ZONESOUND/ITRI-art-residency/tof_distance_sensor/README.md

# VL53L0X 雙 ToF 距離感測模組

ESP32 + 2x VL53L0X ToF（Time-of-Flight）感測器，用於平面同動車 X/Y 軸手把追蹤。
Serial 輸出 OSC 風格格式，可直接接入 Max/MSP。

---

## 🔥 目前燒錄在 ESP32 的版本

**`tof_c3_supermini_vel_norm/`**（位置 + 速度 mm/s + normalized 速度 -1.0~1.0）

> 這是同動車 TOF 那顆 ESP32 上面**實際在跑的韌體**。
> 拆開來複製副本改的時候，記得燒回這版才會跟 Max 端 `paired_motion/` 的 abstraction 設計相符。

---

## 韌體版本

### 目前使用版本

| 目錄 | 板子 | 濾波 | 輸出格式 | 說明 |
|---|---|---|---|---|
| **`tof_c3_supermini_vel_norm/`** | **ESP32-C3 SuperMini** | **三層濾波 + 速度 EMA + 位置不變 snap-to-0 + post-normalize deadband** | **`/tof fX fY rX rY vX vY vXn vYn`**（8 個值）| **目前燒錄版本**：位置 + mm/s 速度 + normalized -1~1 速度 |

### 前一版（仍可用，差別只是沒做 normalize）

| 目錄 | 板子 | 濾波 | 輸出格式 | 說明 |
|---|---|---|---|---|
| `tof_c3_supermini_vel/` | ESP32-C3 SuperMini | 三層濾波 + 速度 EMA + snap-to-0 | `/tof fX fY rX rY vX vY` | normalize 之前的版本，需要 Max 端自己除 500 |

### 封存版本（`archive/`）

依開發順序：

| 目錄 | 板子 | 濾波 | 輸出格式 | 說明 |
|---|---|---|---|---|
| `archive/tof_noSmooth/` | ESP32 Dev Module | 無 | `x=N,Y=M` | 最早版本，原始距離直出 |
| `archive/tof_optimized/` | ESP32 Dev Module | Median + 自適應 EMA | `/tof fX fY rX rY` | 優化版，雙層濾波 |
| `archive/tof_c3_supermini/` | ESP32-C3 SuperMini | Median + 自適應 EMA + Deadband | `/tof fX fY rX rY` | 三層濾波，僅位置 |

> 各版本前 4 個值（fX fY rX rY）格式都相同，向下相容。
> Max patch 端：4 值版用 `[unpack i i i i]`、6 值版用 `[unpack i i i i f f]`、8 值版（目前）用 `[unpack i i i i f f f f]`。

---

## 硬體接線

### ESP32-C3 SuperMini（目前使用）

```
ESP32-C3 SuperMini    VL53L0X #1 (X軸)    VL53L0X #2 (Y軸)
──────────────────    ────────────────    ────────────────
GPIO 5 (SDA) ──────── SDA ──────────── SDA
GPIO 6 (SCL) ──────── SCL ──────────── SCL
3.3V ─────────────── VIN ──────────── VIN
GND ──────────────── GND ──────────── GND
GPIO 4 ──────────── XSHUT
GPIO 3 ─────────────────────────────── XSHUT
GPIO 0 ──────────── 外接按鈕（另一端接 GND，按下重新校正）
GPIO 8 ──────────── 狀態 LED（校正中閃爍，運行中常滅）
```

### ESP32 Dev Module（舊版）

```
ESP32                 VL53L0X #1 (X軸)    VL53L0X #2 (Y軸)
─────                 ────────────────    ────────────────
GPIO 21 (SDA) ──────── SDA ──────────── SDA
GPIO 22 (SCL) ──────── SCL ──────────── SCL
3.3V ─────────────── VIN ──────────── VIN
GND ──────────────── GND ──────────── GND
GPIO 25 ──────────── XSHUT
GPIO 26 ─────────────────────────────── XSHUT
```

> 兩顆感測器共用 I2C 匯流排，透過 XSHUT 腳位依序啟動並重新分配地址（0x30, 0x31）。
> VL53L0X 只能接 3.3V，不可接 5V。

---

## 安裝與燒錄

### 安裝依賴

在 Arduino IDE 中安裝：

1. **Library Manager** → 搜尋 `Adafruit VL53L0X` → 安裝（會自動安裝 `Adafruit BusIO` 等依賴）

### Board 設定

**ESP32-C3 SuperMini（`tof_c3_supermini`）：**

| 設定項目 | 值 |
|---|-----|
| Board | ESP32C3 Dev Module |
| USB CDC On Boot | **Enabled**（必須，否則 Serial Monitor 無輸出） |
| Partition Scheme | Default 4MB with spiffs |

**ESP32 Dev Module（`archive/tof_optimized` / `archive/tof_noSmooth`，封存版）：**

| 設定項目 | 值 |
|---|-----|
| Board | ESP32 Dev Module |

---

## 運作流程

上電後自動進入三階段狀態機：

```
┌─────────┐     200ms     ┌──────────────┐    ~0.8 秒     ┌─────────┐
│  暖機   │ ────────────→ │    校正      │ ────────────→ │  運行   │
│ WARMUP  │  丟棄不穩讀數  │ CALIBRATING  │  收集中位數    │ RUNNING │
└─────────┘               └──────────────┘               └─────────┘
```

### 校正

**目前燒錄的 `_vel_norm` 版校準 ~1 秒完成**（按一下就好，不用等）：

1. **暖機（200ms）**：丟棄開機後不穩定的讀數
2. **校正（~800ms）**：收集有效樣本（~12 筆），取**中位數**作為零點 offset
   - 校正期間請將手把放在**原點位置**不動
   - 中位數比最小值更抗雜訊；~12 筆已足夠穩
3. **運行**：開始輸出濾波後的距離值

> 舊版 `_vel` 與 `archive/` 仍是 500ms 暖機 + 5 秒校正。只有 `_vel_norm` 縮短成 ~1 秒。

### 重新校正

兩種方式：

1. **按鈕**（`_vel` / `_vel_norm`）：按下外接按鈕（GPIO0）→ 重新校正，Serial 不中斷，Max 不需重連。`_vel_norm` ~1 秒就好。
2. **Serial 指令**：發送字元 `c` → 重新校正

校正期間 GPIO8 LED 閃爍（500ms 間隔），完成後熄滅。
> 注意：GPIO8 是 **ESP32-C3 板載 LED**，ToF 單元裝起來通常看不到（不像 Pressure 有外接 WS2812 燈圈）。實務上「校準完成」的依據是 `/cal_done` + `/tof` 數值在原點歸零。

---

## 三層濾波機制（`tof_c3_supermini`）

```
感測器原始讀值 → 歸零(減 offset) → ① Median → ② 自適應 EMA → ③ Deadband → 輸出
```

### ① Median 濾波（殺突波）

- 窗口大小 = 3，對最近 3 筆取中位數
- 感測器偶爾跳一下（如 120→250→120），中位數會直接忽略 250 這個離群值
- 比 EMA 更適合處理突波，因為 EMA 會被拉走好幾幀

### ② 自適應 EMA（靜止穩、移動快）

- 計算新值與目前 EMA 的差距，自動切換平滑係數：
  - 差距 ≤ 10mm（靜止/緩動）→ alpha = 0.12（新值只佔 12%，非常平滑）
  - 差距 > 10mm（快速移動）→ alpha = 0.6（新值佔 60%，快速跟手）
- 比固定 alpha 好在：靜止時不抖、移動時不拖

### ③ Deadband（鎖住微抖）

- 濾波後的值與上次輸出相差 ≤ 3mm → 不更新，鎖住上次的值
- 確保靜止時輸出完全不動

---

## Serial 輸出格式

Baud rate: **115200**

### 訊息格式（OSC 風格）

| 訊息 | 說明 |
|---|---|
| `/tof <fX> <fY> <rX> <rY>` | 4 值版（archive 舊版），僅位置 |
| `/tof <fX> <fY> <rX> <rY> <vX> <vY>` | 6 值版（`_vel`，前一版），位置 + mm/s 速度 |
| **`/tof <fX> <fY> <rX> <rY> <vX> <vY> <vXn> <vYn>`** | **8 值版（`_vel_norm`，目前燒錄版）**，位置 + mm/s 速度 + normalized -1~1 |
| `/status calibrating` | 進入校正（`_vel_norm`：純開始標記，無倒數數字；`_vel`/archive：後面帶剩餘秒數） |
| `/cal_done <offsetX> <offsetY> <samplesX> <samplesY>` | 校正完成 |
| `/status running` | 開始正常運行 |
| `/status velocity_on` / `velocity_off` | 速度輸出開關切換（`_vel` 起的版本） |
| `/status button_recalibrate` | 按鈕觸發重新校正（`_vel` 起的版本） |
| `/status recalibrating` | 重新進入校正流程（`_vel` 起的版本） |
| `/status filters_reset` | 濾波器已重置 |
| `/error <message>` | 錯誤訊息 |

### `/tof` 數值說明（目前燒錄的 8 值版）

```
/tof <fX> <fY> <rX> <rY> <vX> <vY> <vXn> <vYn>
      ↑         ↑         ↑          ↑
      濾波後     僅歸零     速度        normalized 速度
                          (mm/s)      (-1.0 ~ +1.0)
```

| | filtered (fX, fY) | raw (rX, rY) | velocity (vX, vY) | normalized vel (vXn, vYn) |
|---|---|---|---|---|
| 型態 | int (mm) | int (mm) | float (mm/s) | float (-1.0 ~ +1.0) |
| 歸零（offset） | 有 | 有 | — | — |
| 三層濾波 | 有 | 無 | — | — |
| 速度 EMA 平滑 | — | — | 有 | 同 vX/vY |
| Post-normalize deadband | — | — | — | 有（< 0.02 視為 0） |
| Post-normalize EMA | — | — | — | 預留，預設關閉 |
| 用途 | **位置控制** | **除錯** | **絕對速度** | **直接接聲音映射** |

#### 速度 (vX, vY, vXn, vYn) 特性

**vX, vY (mm/s)**：

- 單位：mm/s，帶正負方向
  - 正值 = 遠離感測器（向中線移動）
  - 負值 = 靠近感測器（向邊緣移動）
- 從 fX/fY（deadband 後穩定值）計算
- **位置沒變就直接 = 0**，速度沒有慣性尾巴（不會在停下後緩慢衰減）
- 移動中才套 EMA 平滑（VEL_SMOOTH = 0.06）→ 加速時連續 ramp，不跳動
- 典型範圍：慢 ±50, 中 ±200, 快 ±500~1000

**vXn, vYn (-1.0 ~ +1.0)**：

- normalized 浮點，靜止時 = 0.0（exact）
- 公式：`clip(vX / VEL_MAX, -1.0, 1.0)` 後做 deadband
- VEL_MAX 預設 500，演出當下覺得太敏感（飽和太快）→ 在韌體 .ino 改大、覺得太鈍 → 改小（要重燒）
- abs 落在 < 0.02 直接歸 0（壓掉浮點微抖跟極微小速度）
- 預留 `VEL_NORM_SMOOTH` 參數（預設 0 關閉），要追加平滑改一行常數即可
- Max 端 `[unpack i i i i f f f f]` 接到後直接接 abstraction 的 outlet，不需再 normalize

### Serial 指令

| 指令 | 功能 | 版本 |
|---|---|---|
| `c` | 重新校正（暖機 + 收集；`_vel_norm` ~1 秒、其餘 ~5.5 秒） | 全版本 |
| `r` | 重啟濾波器（清除歷史，保留 offset） | 全版本 |
| `v` | 切換速度輸出開/關（預設開） | `_vel` 版 |

---

## Max/MSP 接線

### 基本接收鏈

```
[serial /dev/cu.usbmodem-XXXX 115200]    ← ESP32-C3 用 usbmodem，ESP32 用 usbserial
        |
    [sel 10]          ← 以換行符號 (ASCII 10) 分割訊息
        |
   [zl group]         ← 收集一行的 bytes
        |
     [itoa]           ← bytes → 字元
        |
   [fromsymbol]       ← 字串 → Max symbol list
        |
  [route /tof /status /cal_done /error]
     |      |         |          |
[unpack i i i i]    ...        ...
  |   |   |   |
 fX  fY  rX  rY
```

### 分離 filtered、raw、velocity、normalized velocity

**目前燒錄版本（`_vel_norm`，8 值）**：

```
[route /tof]
     |
[unpack i i i i f f f f]
 |  |   |  |  |   |  |   |
 fX fY rX rY vX vY vXn vYn
```

各版本對應：

| 韌體版本 | unpack 物件 |
|---|---|
| `archive/tof_c3_supermini`（4 值） | `[unpack i i i i]` |
| `tof_c3_supermini_vel`（6 值） | `[unpack i i i i f f]` |
| **`tof_c3_supermini_vel_norm`（8 值，目前燒錄）** | **`[unpack i i i i f f f f]`** |

### 映射到 GL 座標

現有的 `tof_sensors.maxpat` 將 filtered 值映射為 -1.0 ~ 1.0：

```
filtered_x → [/ 360.] → [* 2.] → [- 1.] → x_gl (-1.0 ~ 1.0)
filtered_y → [/ 320.] → [* 2.] → [- 1.] → y_gl (-1.0 ~ 1.0)
```

### Max/MSP Patch 檔案

| Patch | 說明 |
|---|---|
| `tof_sensors.maxpat` | Serial 接收 + 數值顯示 + GL 座標映射 + pictslider 視覺化 |
| `tof_line_draw.maxpat` | 接收 GL 座標，用 `jit.gl.mesh` 畫連續線條，有拖尾消失效果 |

---

## 參數調整

在 `.ino` 檔案頂部可調整以下參數：

### 感測器參數

| 參數 | 預設值 | 說明 |
|---|---|---|
| `TIMING_BUDGET_US` | 33000 (33ms) | 感測器量測時間，越大越精確但越慢 |
| `OUTPUT_INTERVAL_MS` | 20 (50Hz) | 輸出間隔，不要低於 timing budget 的兩倍 |
| `WARMUP_MS` | 200（`_vel_norm`）/ 500（`_vel`·archive） | 暖機時間 |
| `CALIB_MS` | 800（`_vel_norm`）/ 5000（`_vel`·archive） | 校正收集時間。`_vel_norm` 縮短成 ~1 秒「按一下即校準」 |
| `RANGE_MAX` | 2000 | 有效量測範圍上限 (mm) |

### 濾波參數（位置）

| 參數 | 預設值 | 說明 |
|---|---|---|
| `MEDIAN_WINDOW` | 3 | Median 窗口，越大越抗突波但延遲越高 |
| `ALPHA_SLOW` | 0.12 | 靜止時 EMA 係數，越小越平滑 |
| `ALPHA_FAST` | 0.6 | 移動時 EMA 係數，越大越跟手 |
| `ADAPTIVE_THRESH` | 10.0 | 靜止/移動切換閾值 (mm) |
| `DEAD_BAND_MM` | 3 | Deadband 門檻，低於此變化量不更新 |

### 速度參數（`_vel` 與 `_vel_norm`）

| 參數 | 預設值 | 說明 |
|---|---|---|
| `VEL_SMOOTH` | 0.06 | 速度 EMA 平滑係數，越小 ramp 越緩（連續漸變），越大越即時 |

### Normalize 參數（`_vel_norm` 版專屬）

| 參數 | 預設值 | 說明 |
|---|---|---|
| `VEL_MAX` | 500.0 | normalize 的分母（mm/s）。typical 快動作上限。改大 → normalized 比較不會飽和；改小 → 動一下就達 ±1.0 |
| `VEL_NORM_DEADBAND` | 0.02 | normalize 後 abs 小於此值直接歸 0。壓掉浮點微抖、極微小速度殘留 |
| `VEL_NORM_SMOOTH` | 0.0 | post-normalize EMA。0 = 關閉。> 0 啟用（例如 0.2）會對 normalized 再平滑一層，會犧牲反應力

**VEL_SMOOTH 效果對照**（@ 50Hz）：

| VEL_SMOOTH | 63% 反應時間 | 適合場景 |
|---|---|---|
| `0.03` | ~0.67 秒 | 非常緩慢的漸變，適合環境音控制 |
| `0.06` | ~0.33 秒 | 預設值，平滑漸變 |
| `0.10` | ~0.20 秒 | 較快反應，適合節奏控制 |
| `0.20` | ~0.10 秒 | 即時反應，有少量平滑 |
| `0.35` | ~0.06 秒 | 幾乎即時，但可能有輕微跳動 |

> 反應時間公式：`-DT / ln(1 - VEL_SMOOTH)` 秒

### 調整建議

| 你覺得... | 調什麼 |
|---|---|
| 靜止時還在抖 | `DEAD_BAND_MM` 加大到 4~5 |
| 手動了但反應太慢 | `ALPHA_FAST` 加大到 0.7~0.8 |
| 移動中數值不夠滑順 | `ALPHA_FAST` 降到 0.4~0.5 |
| 偶爾還有突波穿透 | `MEDIAN_WINDOW` 改成 5 |
| 靜止↔移動切換太敏感 | `ADAPTIVE_THRESH` 加大到 15~20 |
| 感測器讀值本身不穩 | `TIMING_BUDGET_US` 加大到 50000 |
| 速度變化太跳 | `VEL_SMOOTH` 降到 0.03 |
| 速度反應太慢 | `VEL_SMOOTH` 加大到 0.10~0.20 |
| 停下後速度沒歸零 | 檢查 `DEAD_BAND_MM`，要讓 fX/fY 真的鎖住才會觸發歸零分支 |
| Normalized 速度動一下就飽和（總是 ±1） | `VEL_MAX` 加大（例：500 → 800） |
| Normalized 速度太鈍（怎麼動都偏小） | `VEL_MAX` 減小（例：500 → 300） |
| 靜止時 normalized 偶爾跳出小數 | `VEL_NORM_DEADBAND` 加大（0.02 → 0.05） |
| Normalized 0→1 爬升太陡，想再柔一點 | `VEL_NORM_SMOOTH` 改成 0.15~0.3 |

---

## 疑難排解

| 問題 | 可能原因 | 解法 |
|---|---|---|
| Serial Monitor 無輸出 | ESP32-C3 未啟用 USB CDC | Tools → USB CDC On Boot → **Enabled**，重新燒錄 |
| `/error sensor1_init_failed` | 感測器接線鬆脫或 I2C 腳位錯誤 | 檢查 SDA/SCL/XSHUT 接線與供電 |
| 數值不動（一直是 0） | 校正時手把不在原點 | Serial 送 `c` 或按外接按鈕重新校正 |
| Max 收不到資料 | Serial port 被 Arduino Serial Monitor 佔用 | 關閉 Serial Monitor 再開 Max |
| Max 收到亂碼 | Baud rate 不對 | 確認 Max 的 serial object 設為 115200 |
| 編譯失敗 `{build.partitions}` | Board 沒選對 | 選 ESP32C3 Dev Module，設好 Partition Scheme |
