ZONESOUND/ITRI-art-residency/live_demo/README.md

# live_demo — Ableton Live Demo 專案

「同動車 Live Demo」的 Ableton Live 現場 demo 專案。與 `paired_motion/`（Max/MSP 演出主程式）是**兩套獨立的東西**，各自開、各自存。

## 檔案位置

```
live_demo/
└── Live_Demo Project/
    ├── ITRI_show_MIDI.als     ← 演出 set 最新版：10/9 排練後調整 MIDI 對應與參數，10/12 第四幕配樂換成 20261007_小星星.aif
    ├── ITRI_show.als          ← 演出 set，10/7 排練調整後的版本
    ├── Live_Demo.als          ← 早期 demo set
    ├── Live_Demo_macstudio.als← demo set 的 Mac Studio 版
    ├── SceneBridge.amxd       ← M4L：從 UDP 7400 收整數 N，觸發 Live 第 N 個 scene（給外部 Max patch 切段落）
    ├── autoStart.amxd         ← M4L：載入後讓 Live 開始播放
    ├── recording_bell.wav、recording_bell_C.wav、recording_melody.wav、Night animals.wav ← 配樂素材（走 Git LFS）
    ├── Ableton Project Info/  ← Ableton 專案 metadata（須含 Project*.cfg，見下）
    ├── Samples/Imported/      ← Collect All and Save 收進來的音檔（走 Git LFS）
    ├── Presets/               ← 專案內的 device presets
    └── Backup/                ← Ableton 自動備份（已被 .gitignore 忽略，不進 repo）
```

## 怎麼開始工作

- **直接開 repo 裡的 set**（演出用 `ITRI_show_MIDI.als`），不要在別的地方另存分身，否則會兩邊改、對不起來。排練現場來不及 push 而另存的，回來後放回這個資料夾再 commit。
- Mac mini 桌面上有一個原生 Finder 捷徑 `Live_Demo.als`（左下角有箭頭圖示），雙擊即可用 Ableton 開啟本尊。
  - 這是 macOS 原生 alias，不是 Unix symlink——後者會每次跳「Verifying…」而且可能開不起來。
  - 換到別台電腦時，這個桌面捷徑不會跟著 git 走，需要各自在該電腦重建（見下）。

## Git / 版本備份

一般流程（在 repo 根目錄）：

```
git add -A
git commit -m "說明這次改了什麼"
git push
```

- **音檔走 Git LFS**：`.gitattributes` 已設定，`live_demo/` 底下的音檔（wav/aif/aiff/mp3/flac/m4a）會自動走 Git LFS，不會撐爆 git 歷史。未來在 Ableton 按 **Collect All and Save** 收進 `Samples/` 的音檔都會自動走 LFS。
- **`Backup/` 不進 repo**：Ableton 自動備份由 `.gitignore` 排除（git 本身就在做版本控制）。
- **`Ableton Project Info/` 必須含 `Project*.cfg`**：這顆 cfg 是 Ableton 判定「這個資料夾是一個 Project」的依據。一般的 Cmd+S **不會**產生它，只有 File → **Collect All and Save**（或 File → Manage Files → Manage Project）才會寫入。cfg 不存在時該資料夾會是空的，而 **git 無法追蹤空資料夾**，clone / pull 到另一台就不會被認成專案。commit 前先確認 Finder 裡看得到這顆 cfg。
- **commit 前確認 LFS 生效**：`git lfs ls-files` 應列出 `Samples/` 底下的音檔。若在沒裝 git-lfs 的環境 commit，音檔會以原始檔進歷史（撐大 repo），需 reset 重來。

## 換到其他電腦時（例如非 Mac mini）

1. `git clone` 本 repo。
2. **裝 Git LFS**（否則音檔只會拿到指標檔）：
   ```
   brew install git-lfs
   git lfs install
   git lfs pull        # 把音檔實體抓下來
   ```
3. 用 Ableton 開 `live_demo/Live_Demo Project/Live_Demo.als`。
4. （選用）在該電腦桌面自建捷徑：Finder 裡對 `Live_Demo.als` 按右鍵 →「製作替身 / Make Alias」→ 拖到桌面。

## GitHub LFS 額度

免費 1GB 儲存 + 1GB/月流量，一般 demo 足夠；音檔大量成長時再評估付費或改策略。
