ZONESOUND/ITRI-art-residency/(commit log)

2026-05-05 fix(tof_vel): snap velocity to 0 when position unchanged
    EMA smoothing was applied unconditionally, so velocity decayed slowly
    (~2s tail) instead of going to 0 the moment movement stopped. Velocity
    should be a derivative of position — no movement, no velocity, no
    phantom inertia. Now we only smooth while fX/fY is actually changing.
    Also corrects README which previously claimed velocity was 0 when
    stationary; that was the intent but not the behavior.
    [tof_c3_supermini_vel.ino]
2026-05-05 tweak(breath_c3): exponential dot speed + dynamic tail length
    LED dot rotation now uses speed ∝ out² / 10 (signed) so light blowing
    spins slowly and strong blowing accelerates dramatically. Tail length
    scales with airflow strength (2~8 LEDs) instead of fixed 3, with a
    longer decay curve. README updated to match.
    [breath_0115_c3.ino]
2026-05-05 add piezo_detect_who firmware + label pressure_2hands_light outlets
    - piezo_detect_who: single-channel 8kHz piezo streamer with WHO
    identification protocol (responds "ID:piezo"), based on piezo_detect.ino.
    Separate from piezo_4drum — for FluCoMa / MuBu / SC feature extraction.
    - pressure_2hands_light: add comment labeling the unpack outlets
    (hand1_f, hand2_f, hand1_raw, hand2_raw).
2026-05-05 docs(pressure): add pressure_sensor README
    Documents the dual-FSR + dual-LED-ring pressure module for the
    同動車 (Synchronous Movement Vehicle): hardware, three-state
    calibration/idle flow, /pressure output format, WHO protocol,
    tunables, troubleshooting. Includes design context from the Yi-Shan
    day-care workshop observations (per Paul's 2026-03-27 notes) — why
    hands are kept independent and why IDLE_TIMEOUT can't be short.
2026-05-05 docs(readme): restructure top-level README around 同動車 trio
    - Group pressure / tof / piezo as the 同動車 trio with WHO IDs;
    list breath, duo_pulse, piezo_detect_who, piezo_detect_fft, and
    vision modules as standalone.
    - Add a WHO Identification Protocol section explaining how to
    distinguish the three sensors on a shared USB Hub, including
    the known DEVICE_ID collision between piezo_4drum and
    piezo_detect_who.
    - Replace generic one-liners with concrete per-module descriptions
    (filter chain, output format, latest firmware folder, etc.) and
    link to each subdirectory README.
    - Project framing now references 節奏繞纏 / Rhythmic Entanglements
    and the 同動車 (Synchron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
2026-05-05 chore: archive old firmware/patches under each sensor's archive/
    Mark the current production versions and move all earlier firmware /
    Max patches into archive/ subdirs:
    - tof_distance_sensor/archive/: tof_c3_supermini, tof_optimized, tof_noSmooth
    - pressure_sensor/archive/: pressure_2hands.maxpat (older Max patch)
    - piezo_detect/archive/: piezo_paul, piezo_detect.ino, piezo_demo1.maxpat,
    led_test (small LED test utility)
    Current code stays at top level: tof_c3_supermini_vel/, pressure_2hands/,
    piezo_4drum/. Latest Max patches stay at top level: tof_sensors.maxpat,
    tof_line_draw.maxpat, visualization/tof_visual.maxpat,
    pressure_2hands_light.maxpat, piezo_demo2.maxpat. Update tof and
    press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
2026-05-05 docs(piezo_4drum): document /piezo/stream + sync pin map and params
    Update README to match the current piezo_4drum.ino:
    - Pin map matches the latest GPIO mapping (piezo: 4/3/0/1, LED: 6/5/10/7)
    - Document the /piezo/stream continuous output (50Hz, post-baseline)
    alongside the discrete /piezo hit events, and explain the design
    split (hit → discrete sound, stream → continuous control)
    - Parameter table updated to actual defaults (THRESHOLD_DELTA=250,
    HITS_REQUIRED=4) and adds BASELINE_ALPHA_SHIFT, FILTER_SHIFT,
    LED_MIN_MS, LED_MAX_MS, LED_ACTIVITY_THRESHOLD, STREAM_INTERVAL_MS
    - Reference piezo_demo2.maxpat as the implementation example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
2026-05-05 feat(tooling): add serial_auto_detect for WHO-based USB port discovery
    Node.js script for Max [node.script] that auto-discovers which USB port
    each 同動車 sensor is on by sending "WHO\n" and matching the
    "ID:tof|pressure|piezo" responses. Solves the USB Hub port-order
    ambiguity so users don't have to manually identify ports each time.
    Outputs port names (without /dev/tty. prefix) on outlets named after
    each device ID, plus "missing"/"done"/"error" status outlets.
    Auto-runs on load and re-runs on "scan" or bang.
    node_modules already covered by .gitignore.
    [auto_detect.js]
2026-05-05 tweak(piezo_demo2): add manual bang button to gate the trigger chain
    Insert a bang (obj-84) between obj-1 and the downstream obj-32/obj-34
    so the chain can be re-fired manually. Also picks up the latest
    usbmodem port names from this session.
2026-05-06 docs(serial_auto_detect): add module README + diagnostic CLI + Max test patch
    serial_auto_detect/
    - README.md: usage guide, code logic walkthrough, six caveats from
    this debugging session (ESP32-C3 USB CDC boot reset timing,
    Node-for-Max init delay, Max [serial] needs metro driver, [serial]
    port-letter auto-grab race condition, Resource busy after auto-open,
    firmware WHO support requirement)
    - who_probe.js: standalone CLI tool for single-port WHO probe with
    timestamped raw byte logging, bypasses Max for diagnostics
    - auto_detect.js: longer boot wait (1200ms) + retry every 400ms +
    buffer dump on failure for clearer error output
    - auto_detect_test.maxpat: minimal patch demonstratin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
    [auto_detect.js, who_probe.js]
2026-05-06 docs(piezo_detect): add top-level README
    Folder previously had only piezo_4drum/README.md (firmware-level docs).
    Adds an overview README at the piezo_detect/ top level describing:
    - The "one interface, two interaction modes" design (hit events vs
    continuous stream for tap vs scratch/touch)
    - Current vs archived firmware versions
    - Serial output formats (both /piezo and /piezo/stream)
    - Cross-links to piezo_4drum/, archive/, and serial_auto_detect/
    Matches the README pattern already used by pressure_sensor/ and
    tof_distance_sensor/.
2026-05-06 feat(paired_motion): scaffold integration project for art residency demo
    Sets up paired_motion/ as the performance-grade integration folder for the
    ITRI art residency demo (同動車 / Synchronous Movement Vehicle integrating
    the Pressure / TOF / Piezo trio). Companion to serial_auto_detect/ but
    distinct in lifecycle: serial_auto_detect/ stays the lab/debug environment,
    paired_motion/ is frozen at known-good state for performance.
    Skeleton only — sensor abstractions, sound design, and main patch logic
    to be authored manually. Folder layout:
    paired_motion/
    ├── paired_motion.maxproj Max Project root, auto search-path
    ├── main.maxpat Skeleton with [node.scr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
2026-05-06 feat(tof): add tof_c3_supermini_vel_norm — firmware-side velocity normalization
    User decision: do velocity -1.0~+1.0 normalization on the firmware side
    rather than in Max abstractions. Cleaner downstream patches, all sensors
    share the same "single layer" output convention.
    New firmware (copied from tof_c3_supermini_vel/, NOT in-place modified):
    - Output now 8 floats: /tof fX fY rX rY vX vY vXn vYn
    - vXn = clip(vX / VEL_MAX, -1.0, 1.0) with VEL_MAX = 500 mm/s
    - Post-normalize deadband (VEL_NORM_DEADBAND = 0.02) to suppress
    floating-point jitter at near-zero velocities
    - Optional post-normalize EMA reserved (VEL_NORM_SMOOTH = 0 by default,
    set > 0 to add smoothing if needed)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
    [tof_c3_supermini_vel_norm.ino]
2026-05-06 docs: replace 倉庫 with 資料夾 (Taiwan-natural wording)
2026-05-06 patch(paired_motion): user-edited main + sub_tof in progress
    User's hand-edited working state of paired_motion patchers — committed
    as a restore point. Content drives by user, not modified by Claude.
2026-05-06 tune(piezo_4drum): raise LED_ACTIVITY_THRESHOLD 30 → 100
    Environmental EMI / USB hub crosstalk creates occasional 100+ spikes
    in /piezo/stream output even when nothing's touching the piezo discs.
    Baseline noise is healthy (0-20), but spikes were enough to trigger
    LED at threshold=30, making LEDs visually flash constantly during
    演出 setup.
    Raise LED-only threshold to 100 to suppress these false triggers.
    Hit detection (THRESHOLD_DELTA=250) is unchanged — strikes still
    register the same way.
    Trade-off: very light touches that produce only 30~100 activity
    will no longer light LEDs, but will still appear in /piezo/stream
    for downstream Max processing.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
    [piezo_4drum.ino]
2026-05-06 feat(piezo_4drum): add consecutive-frame debounce on LED trigger
    Single-sample EMI spikes (e.g. /piezo/stream jumping to 100+ from
    USB hub crosstalk or environmental noise) were still triggering
    LED even after raising LED_ACTIVITY_THRESHOLD to 100, because
    sufficiently large spikes still cross the threshold for one frame.
    Add LED_HITS_REQUIRED = 2 — LED only lights when activity stays
    above threshold for 2 consecutive frames. Single-sample spikes
    (which is what EMI looks like) never satisfy this, so they're
    fully filtered out. Real finger touches naturally span many frames
    so latency is negligible (a couple of loop iterations, sub-ms).
    Mirrors the existing HITS_REQUIRED=4 pattern used fo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
    [piezo_4drum.ino]
2026-05-06 chore(paired_motion): consolidate project — pull in samples, Cycling74 abstractions, externals
    User ran Max Project's Consolidate. Effects:
    - 4 audio samples copied into paired_motion/media/ (~19 MB total):
    Bubbles_ Big_ Fast_ Gurgling Up.aif (4.4M)
    EQ-Lp011 Ejects Rhythm 065.wav (1.9M)
    EQ-Lp013 Express Rhythm 065.wav (1.9M)
    Heavy Cold Gusts Howling.aif (10M)
    - 9 Cycling74 abstractions copied into patchers/:
    p_resonators~.maxpat, p_resontaps~.maxpat
    vs.between, vs.explist, vs.pan~, vs.random,
    vs.scale, vs.scale2, vs.sig~
    - 2 PeRColate externals copied into externals/:
    bowedbar~.mxo, bowed~.mxo
    - openactions.txt added (Max-generated)
    Result: paired_m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
2026-05-06 fix(paired_motion): disable node.script autowatch in sub_auto_detect
    The [node.script auto_detect.js] object had autowatch=1 in its textfile
    block. Max was repeatedly trying to register a file watcher for
    auto_detect.js across project search paths, leaving stale subscription
    entries that fired "getfn (filechanged): corrupt object" warnings every
    time the patch loaded — twice on each open, even with no real corruption.
    Setting autowatch=0 stops Max from watching the JS file. We don't edit
    auto_detect.js while the patch is running anyway — @autostart 1 still
    covers initial script load on patch open.
    Result: console is clean on patch load. auto-detect functionality
    unchanged (verified: th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
2026-05-06 patch: user iteration — main / sub_piezo / piezo_4drum tuning
    User-driven edits since previous commit. Restore point captured.
2026-05-06 docs: README sync — add paired_motion, drop piezo_detect_who refs, sync LED params
2026-05-06 docs(readme): expand paired_motion section, reframe phased modules, add arduino_template
    Main README restructure per user request:
    Expand paired_motion section into a dedicated detail block with:
    - 設計構想 (design concept) — explains the 'same-motion' observation
    from Paul's Tamsui daycare workshop, how it shaped the trio's
    bimanual differentiation design, and the multi-modal feedback
    strategy
    - 系統架構 (system architecture) — ASCII diagram showing the full
    stack from ESP32-C3 hardware through node.script auto-detect to
    sub_* abstractions and audio out
    - 未來應用 (future applications) — concrete pathways: residency
    finale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
2026-05-06 chore(paired_motion): drop unused bootstrap.js, restructure README
    bootstrap.js was authored earlier in this session as a "first-run
    auto-installer" wrapper around auto_detect.js. User decided the manual
    [npm install] button in main.maxpat is simpler and more transparent —
    bootstrap.js was redundant. Removed.
    package.json:
    - main: bootstrap.js → auto_detect.js
    - description: drop "+ bootstrap" wording
    paired_motion/README.md restructure:
    - Move 快速開始 (Quick Start) to the top so first-time users see the
    five-step workflow before anything else
    - Add 系統架構 ASCII diagram showing the full data flow from ESP32
    hardware through node.script → [serial] → bpatch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
2026-05-06 docs(readme): trim main README — drop architecture section, deduplicate module details
    Per user feedback: 系統架構 (system architecture) was duplicated between
    main README and paired_motion/README.md. Made the main one too long.
    Removed from main README — paired_motion/README.md keeps its own version
    which is the authoritative one for that patch.
    Other deduplication:
    - Drop the 各模組說明 (Module Details) section entirely. It was just
    a longer-form repeat of the descriptions already in 資料夾結構.
    Each folder has its own README for actual details.
    - Merge 主要使用的工具與函式庫 + 硬體 into a compact 開發環境 section
    (no separate hardware li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
2026-05-06 docs(readme): restore brief English summaries to all sections
    User feedback: bilingual format is preferred and the opening style is
    good. Previous trim dropped English from 未來應用 / WHO / 開發環境
    sections. Restored as one-paragraph English summaries (not full
    translations) — keeps the trim spirit while preserving bilingual
    accessibility for non-Chinese collaborators.
2026-05-06 docs(readme): correct 同動車 origin context, switch to functional description
    Substantive correction: 同動車 is an EXISTING stroke rehabilitation
    device developed by an ITRI lab (using the 'well-hand-leads-affected-
    hand' bimanual mechanism for upper-limb recovery), NOT a name coined
    by this residency. Previous prose framed it as 'observed elderly
    synchronization → named the device after it' — that's wrong and
    misattributes both the device and the rehab principle.
    Rewrites:
    - Top intro: name the device's actual origin (ITRI lab rehab tool),
    describe what this residency adds (sensor instrumentation +
    sonification), drop the made-up etymology
    - Replace 設計構想 (whic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
2026-05-20 feat(paired_motion): add ToF trajectory visualization (browser, SSE)
    In-Max → Node-for-Max → browser visualization pipeline.
    - visualization/server.js: SSE broadcaster; registers '/tof' and 'list'
    handlers (accepts prefixed or bare-list inputs from sub_auto_detect);
    forwards fX/fY/vX/vY plus normalized vXn/vYn.
    - visualization/index.html: trail + heatmap modes; all velocity-driven
    visuals (color, line width, glow, heatmap weight) now driven by
    vXn/vYn from tof_c3_supermini_vel_norm firmware (exact-zero at rest).
    HUD adds vXn/vYn readout; mm/s fallback retained for older firmware.
    - patchers/sub_visualization.maxpat: drop-in module with [r tof] +
    node.script + script start/st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
2026-06-03 patch(paired_motion): piezo threshold tuning, auto-start node.script in sub_auto_detect
    - sub_piezo: lower trigger thresholds and trim ranges for current piezo response
    - sub_auto_detect: add loadbang -> "script start" so auto_detect.js launches on patcher load
2026-06-23 tune(tof): fast ~1s calibration — WARMUP 200ms, CALIB 800ms
    Button-press recalibration now completes in ~1s instead of ~5.5s
    (collects ~12 samples, median offset is plenty). Countdown message
    now derived from CALIB_MS instead of hardcoded.
2026-06-23 tune(tof): drop vestigial calibration countdown number
    ~1s calibration doesn't need a countdown; just emit /status calibrating
    as a start marker, completion signalled by /cal_done + /status running.
    Removed the periodic countdown print block.
    [tof_c3_supermini_vel_norm.ino]
2026-06-23 docs: sync docs to ToF fast-calibration + simpler tags + arduino-cli
    - tof README/header: ~1s calibration (_vel_norm), no countdown number,
    note GPIO8 LED not externally visible, fix CALIB/WARMUP tables
    - paired_motion README: version tags -> 排練/演出/展覽-YYYYMMDD
    - serial_auto_detect README: TOF firmware path -> _vel_norm (actual flashed)
    - CLAUDE.md: arduino-cli flash workflow + port-suffix mapping
    [tof_c3_supermini_vel_norm.ino]
2026-06-23 feat(paired_motion): integrate IOTA M4L device + snapshot
    Load Iota.amxd via amxd~ in main.maxpat; save amxd~ snapshot to
    data/Iota.amxd.maxsnap for state recall.
2026-06-24 pressure added sounds
2026-07-07 update tof mapping and main wiring
2026-07-07 add Ableton live demo project + set up Git LFS for its audio
    - live_demo/ holds the "同動車 Live Demo" Ableton set (.als only, 268K)
    - .gitattributes: route live_demo/ audio (wav/aif/mp3/...) through Git LFS
    so future "Collect All and Save" samples don't bloat git history
    - .gitignore: skip Ableton Backup/ auto-backups and Icon files
    - existing paired_motion/media audio left as-is (plain git, unaffected)
2026-07-07 rename live demo project to ASCII-only names
    同動車 Live Demo Project 2 -> Live_Demo_Project
    同動車 Live Demo.als -> Live_Demo.als
2026-07-07 docs: add live_demo README + work log; re-save als
    - live_demo/README.md: how to open, LFS, cross-computer clone steps
    - 工作日誌.md: work log with 2026-07-07 entry (LFS + Ableton setup)
    - Live_Demo.als re-saved by Ableton (Backup/ correctly gitignored)
2026-07-07 remove misplaced 工作日誌.md (work log lives in Obsidian daily note)
    Keep live_demo/README.md as repo-level technical doc.
2026-07-25 adjust main interface to see live values of sensors
2026-07-29 live_demo: 收整完整 Ableton 專案 Live_Demo Project(Samples/Presets/autoStart.amxd),移除舊的錯名路徑;更新 paired_motion 三個 patch
    [Cache.cfg]
2026-08-24 main: 新增 OSC 輸出 (udpsend) — tof_x/y、pressure_1/2、piezo1~4
    - main.maxpat: 加 [udpsend 192.168.0.189 10000]，各感測器值 prepend OSC 位址後送出
    - sub_tof.maxpat: 加 [s tof_x] [s tof_y]，供 main 端 [r] 取用
    - sub_pressure.maxpat: 僅視窗位置/版本號差異
2026-08-24 main: OSC 目標 IP 可現場切換(textedit + host preset + port)
    - [textedit @outputmode 1] → [prepend host] → udpsend,現場輸入 IP 按 Enter 即切換
    - preset message: host 127.0.0.1 / host 192.168.0.189 / host 192.168.1.100(現場改)
    - [port 10000] message,需要時可改埠號
    - 加背景 panel + 說明文字,整組放進 presentation 模式(y 330-388)供演出時操作
    - udpsend 下移至 y 1060 讓新的控制列在其上方,訊號由上往下
2026-09-02 main: 介面版型調整(presentation 佈局、視窗尺寸)、註解措辭修正
2026-09-02 main: 介面版型調整(presentation 佈局、視窗尺寸)、註解措辭修正
    與 origin/master 的差異經逐一比對，功能零改動:
    - patchline 連線 76 -> 76，新增 0、刪除 0
    - OSC 區塊(udpsend、8 個 prepend、host preset、port)原封不動
    - obj-110 為新增的 comment「顯示現在哪一隻手把有握力」
    (原為 obj-27，與遠端 OSC 的 prepend /tof_y 撞號，改號後無重複 id)
    - obj-102 outlettype 變動為 Max 9.1.1 -> 9.1.4 重存的 metadata
2026-09-02 gitignore: 排除 Ableton .asd 分析快取,並將已追蹤的 181 個移出索引
    .asd 是 Live 對音檔的波形/transient 分析快取,每次開啟 set 時 Live 都會
    重寫,實測 Mac Studio commit 的版本在另一台開啟後 6754 bytes 中有 2216
    bytes 不同。追蹤它們等於保證兩台機器互相覆寫、在 binary 檔上撞 conflict。
    clip 的 warp 資訊存在 .als(每個 SampleRef 各帶 WarpMarkers/WarpMode/
    IsWarped),不依賴 .asd,因此移除後另一台 pull 下來播放結果完全一致,
    只是首次載入時 Live 需重新分析一次。
    音檔本體(181 個 .wav/.aif)完整保留追蹤;git rm --cached 只動索引,
    本機 .asd 檔案未刪除。
    Co-Authored-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
2026-09-08 paired_motion: main 版型微調、sub_pressure 拆掉 flonum→live.gain~ 兩條連線
    - main.maxpat：物件位置重排、視窗尺寸、部分 patchline 隱藏、umenu 預設值歸 0
    - sub_pressure.maxpat：移除 obj-55→obj-58、obj-6→obj-54（flonum 直驅 live.gain~）
    - Max 9.1.5 存檔
    Claude-Session: https://claude.ai/code/session_01Fb4FTpJTyFqKPFuyYWgpD4
2026-09-08 live_demo: 更新 Live_Demo.als，新增三個音檔（LFS）
    - Night animals.wav (49 MB)、recording_bell.wav (123 MB)、recording_melody.wav (35 MB)
    - .asd 分析快取依 .gitignore 不入庫
    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
2026-09-09 paired_motion: voice_gate 門檻放寬 + 加監看 flonum;main 版型放大
    - sub_voice_gate: 開門 >0.15→>0.05、關門 <0.08→<0.02(左右手各一組),
    壓力較輕也能觸發;兩路各接一個 flonum 現場監看實際壓力值
    - sub_pressure: 補回 obj-6→obj-54、obj-55→obj-58 兩條連線
    - main: 視窗由 1276×714 放大為 1852×954,底部數值區對齊微調,
    標題文字顏色改為較深的琥珀色
    - Live_Demo.als: Ableton 專案同步更新
    Claude-Session: https://claude.ai/code/session_0149ZPVmARNSHV95ypo6tUgc
2026-09-16 paired_motion: sub_tof／sub_pressure 對應排練調整;main 連線更新
2026-09-16 live_demo: 新增 ITRI_show.als(之後排練用本尊)+16 個引用中的樣本(LFS);更新 Live_Demo.als
    未被任何 set 引用的 12 個環境音素材(約 270MB)暫不入庫，留在本機待確認。
2026-10-02 live_demo: 補 commit 12 個 .als 引用中但未追蹤的樣本(LFS)
2026-10-03 live_demo: ITRI_show.als 重新連結 Quartz Chimes／Rainstick 01／Werkzeugkasten 三個樣本（9/23 在另一台存成遺失狀態）
2026-10-06 docs: 統一淡水義山公共托老中心名稱，修正同動車開發者歸屬
    - 「淡水義山日照中心」→「新北市淡水義山公共托老中心」（README.md、
    pressure_sensor/README.md、paired_motion/README.md）
    - 同動車開發者：工研院實驗室 → 富伯生醫（Rehabotics），工研院音樂與動作
    互動健促實驗室加入動作追蹤與數據紀錄（README.md 中英、CLAUDE.md）
    Claude-Session: https://claude.ai/code/session_01N3kCNgvckWBbLvxc9RGeA7
2026-10-07 paired_motion: main 場景標籤更新(音樂漸收/漸進、第二幕無聲)+編號註解;ITRI_show.als 排練調整
2026-10-10 live_demo: 新增 ITRI_show_MIDI.als（10/9 排練後版本，調整 MIDI 對應與參數，聲音檔未變）
2026-10-10 sound_tools: 收錄專案用的聲音處理腳本（drift_engine、collage、backing_pads、child_voice_seg、stems_match、tape_fx、tape_drift 等）
2026-10-10 sound_tools: 離線聲音工具整合成 soundtools 套件與指令列
    把《節奏繞纏》期間散在六個專案子夾的腳本整理成一個 uv 管理的 Python 套件：
    varispeed 多聲部漂移／耦合／回歸／硬對齊、磁帶效果（wow flutter、飽和、
    磁頭衰減、串音、tape echo、reverse delay、殘響、tape stop）、拼貼與電平器、
    paulstretch、顆粒雲、樂句邊界（pyin 型態比對）、音節切分（停頓＋能量峰＋
    可選 allosaurus）、stems 回對原檔。另附 tape_drift 網頁版與 gen~ 版。
    六個子命令皆以真實素材驗證（見 sound_tools/README.md 驗證段）。
    硬寫的 iCloud 路徑全部改為參數；本案專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
2026-10-11 docs: 重寫根目錄 README（入口對照表、完整檔案樹、各資料夾功能與用途、資料流）；更新 live_demo 檔案樹
2026-10-12 live_demo: ITRI_show_MIDI.als 10/12 版，第四幕配樂換成 20261007_小星星.aif（新增，LFS）；README 標註最新版
